pluyckx/SensorPcb/data/schema/Sensor.pdf

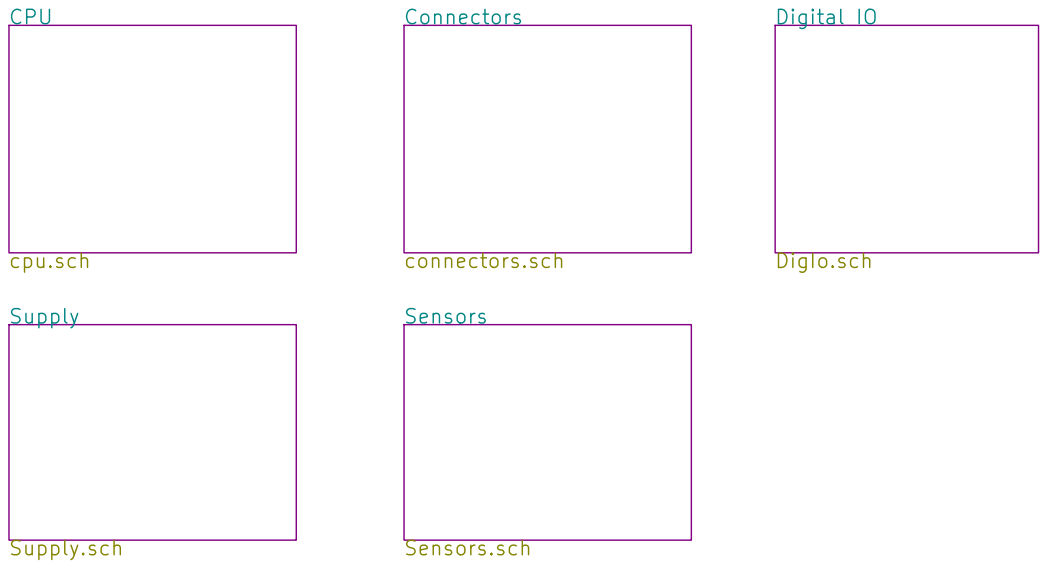
[picture p1: page 1]

Id: 1/6 Title: Sensor File: Sensor.sch Sheet: / Philip Luyckx

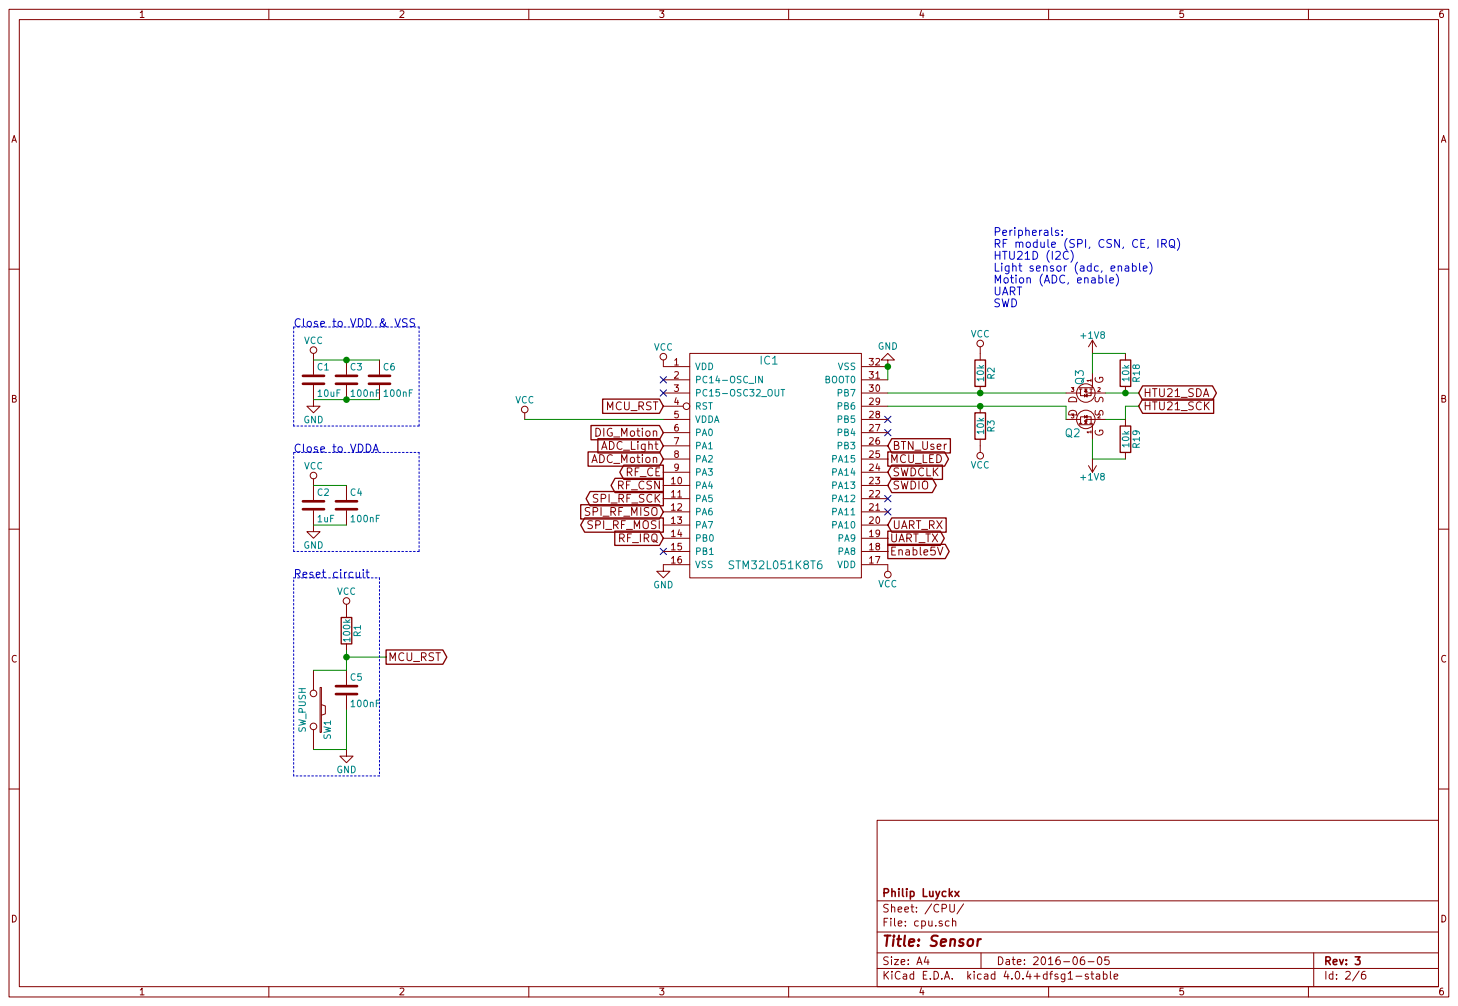
[picture p2: page 2]

Peripherals:
RF module (SPI, CSN, CE, IRQ)
HTU21D (I2C)
Light sensor (adc, enable)
Motion (ADC, enable) UART SWD

100nF VCC GND Close to VDDA

File: cpu.sch Sheet: /CPU/ Philip Luyckx

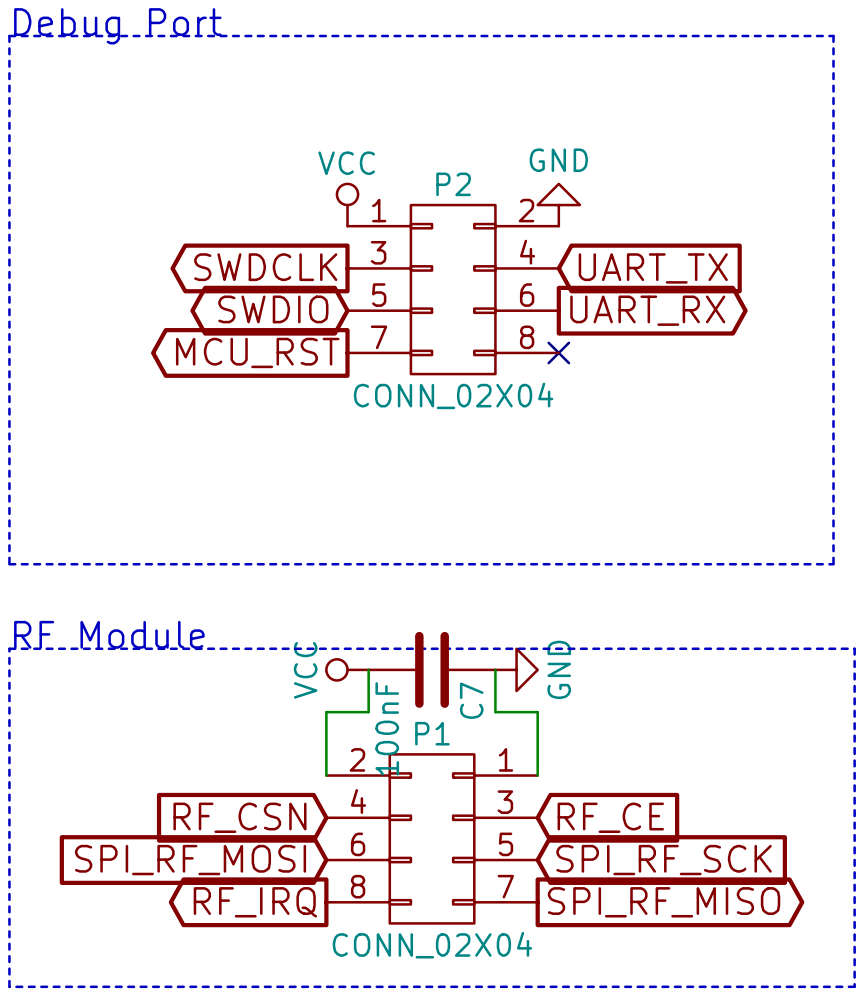
[picture p3: page 3]

Id: 3/6 Title: Sensor File: connectors.sch Sheet: /Connectors/ Philip Luyckx

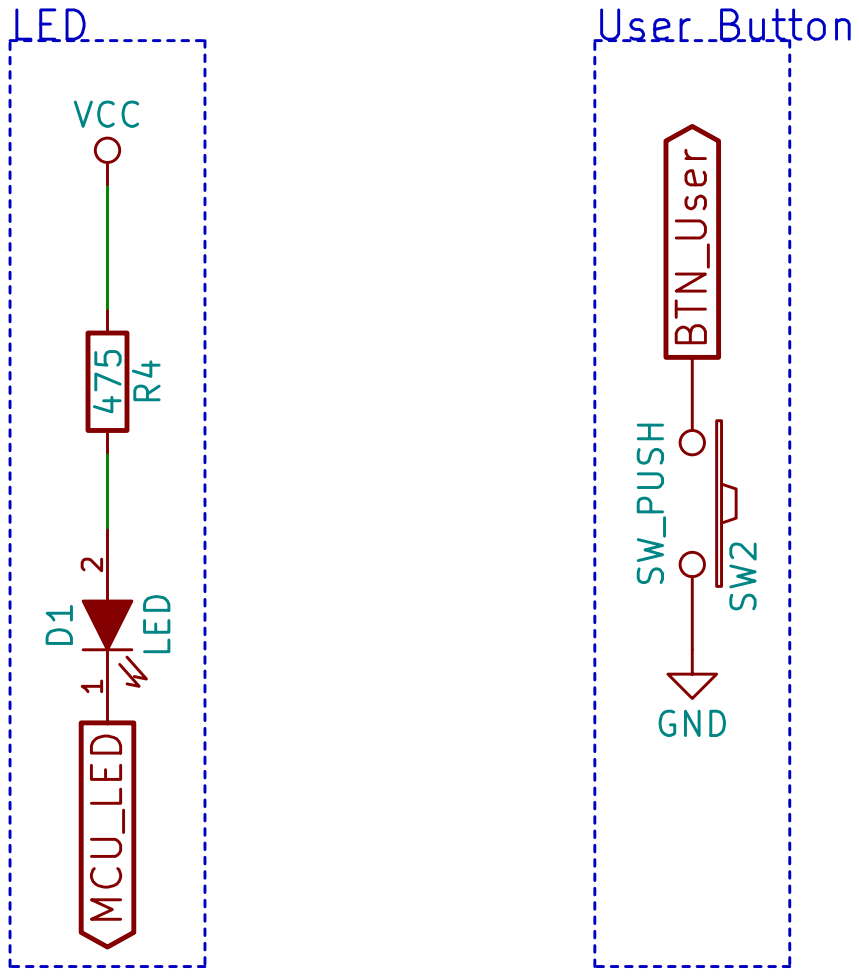
[picture p4: page 4]

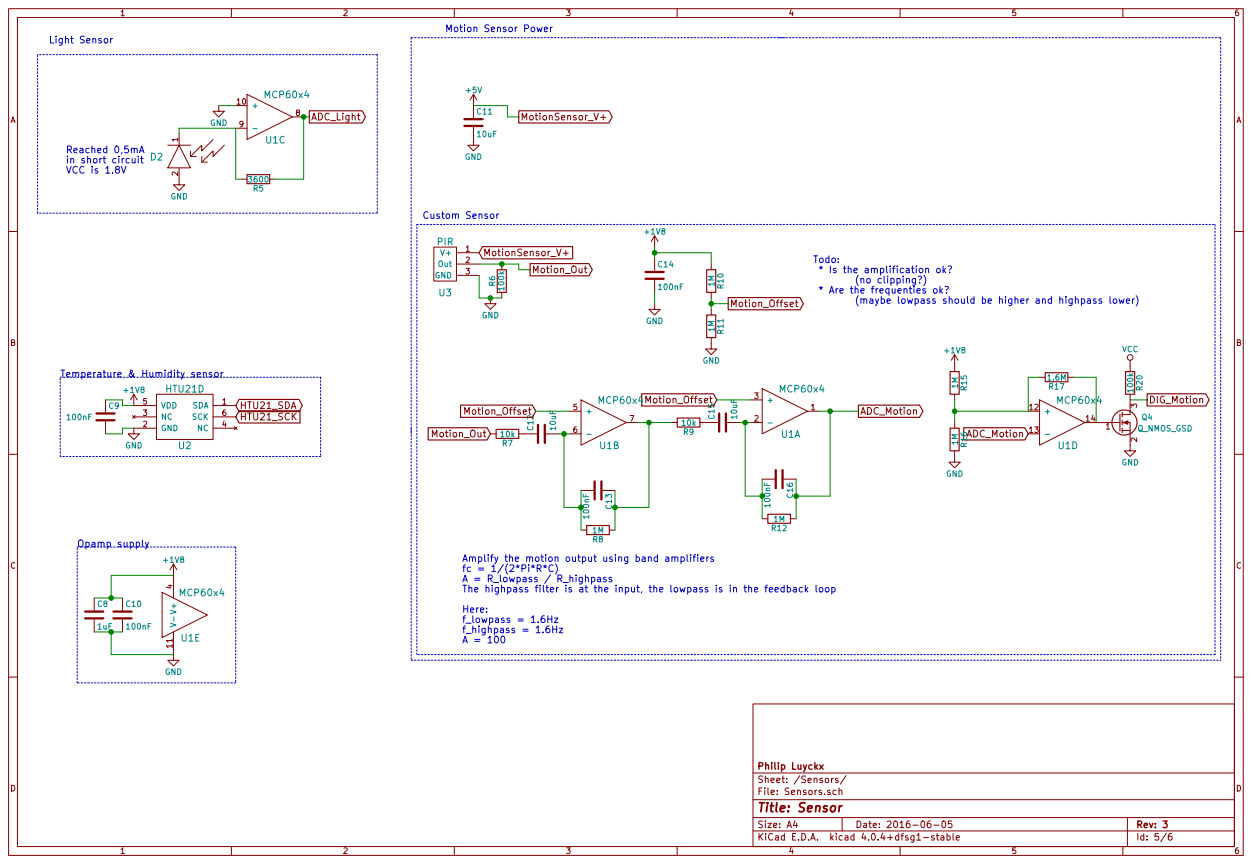
[picture p5: page 5]

(maybe lowpass should be higher and highpass lower) 1 2 D2 Reached 0,5mA
in short circuit VCC is 1.8V

* Is the amplification ok?
(no clipping?)
* Are the frequenties ok?

Amplify the motion output using band amplifiers
A = R_lowpass / R_highpass
The highpass filter is at the input, the lowpass is in the feedback loop Here:

Id: 5/6 Title: Sensor File: Sensors.sch Sheet: /Sensors/ Philip Luyckx

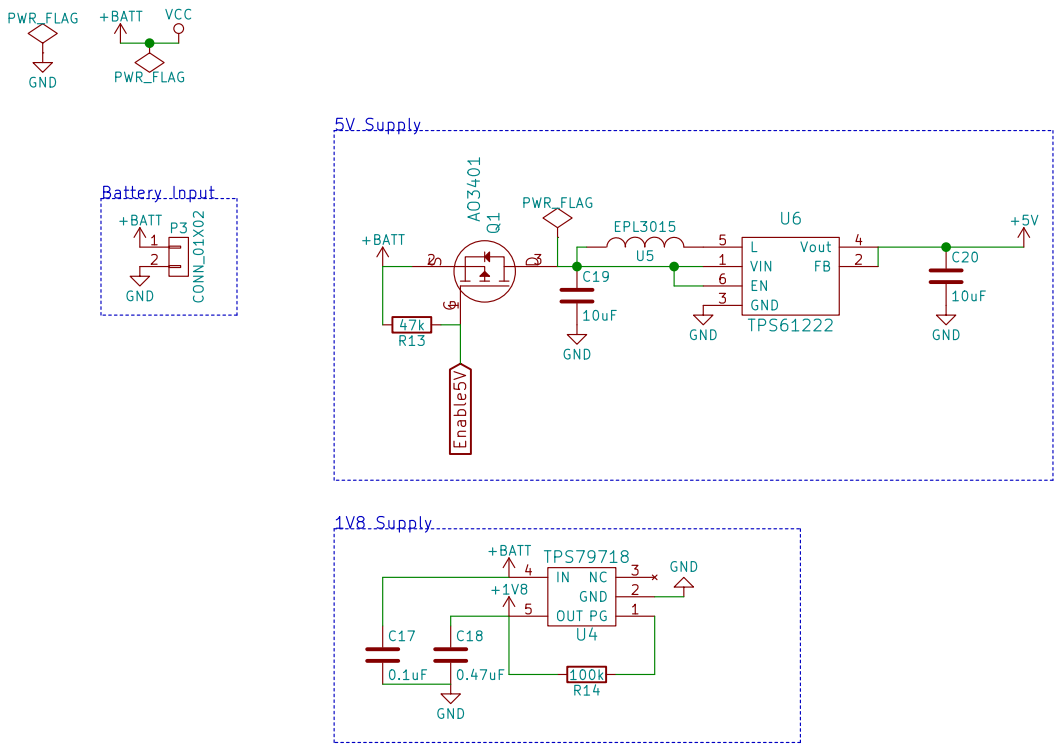
[picture p6: page 6]

2 P3 CONN_01X02+BATT GND Battery Input +BATT GND
PWR_FLAG
