pluyckx/SensorPcb/data/pcb/pdf/pcb-size.pdf

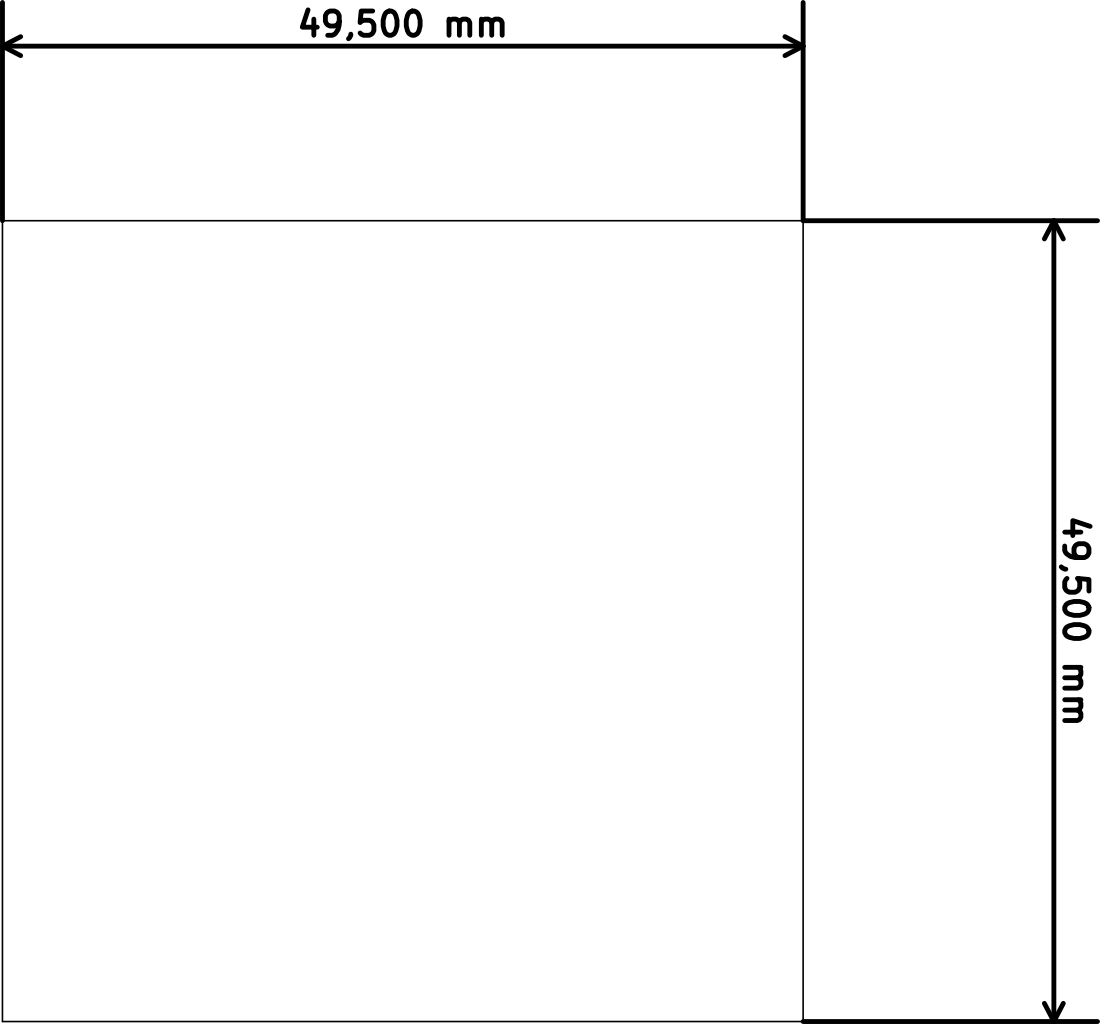
[picture p7: page 1]
