pluyckx/SensorPcb/data/pcb/pdf/Sensor-both-layers.pdf

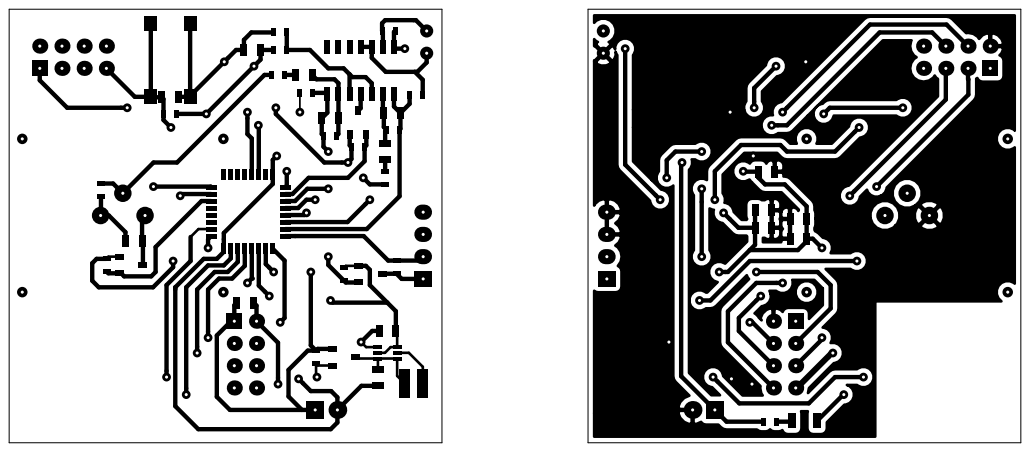
[picture p8: page 1]
