pluyckx/SensorPcb/Sensor.kicad_pcb

## KiCad design Sensor.kicad_pcb (2017-04-18)

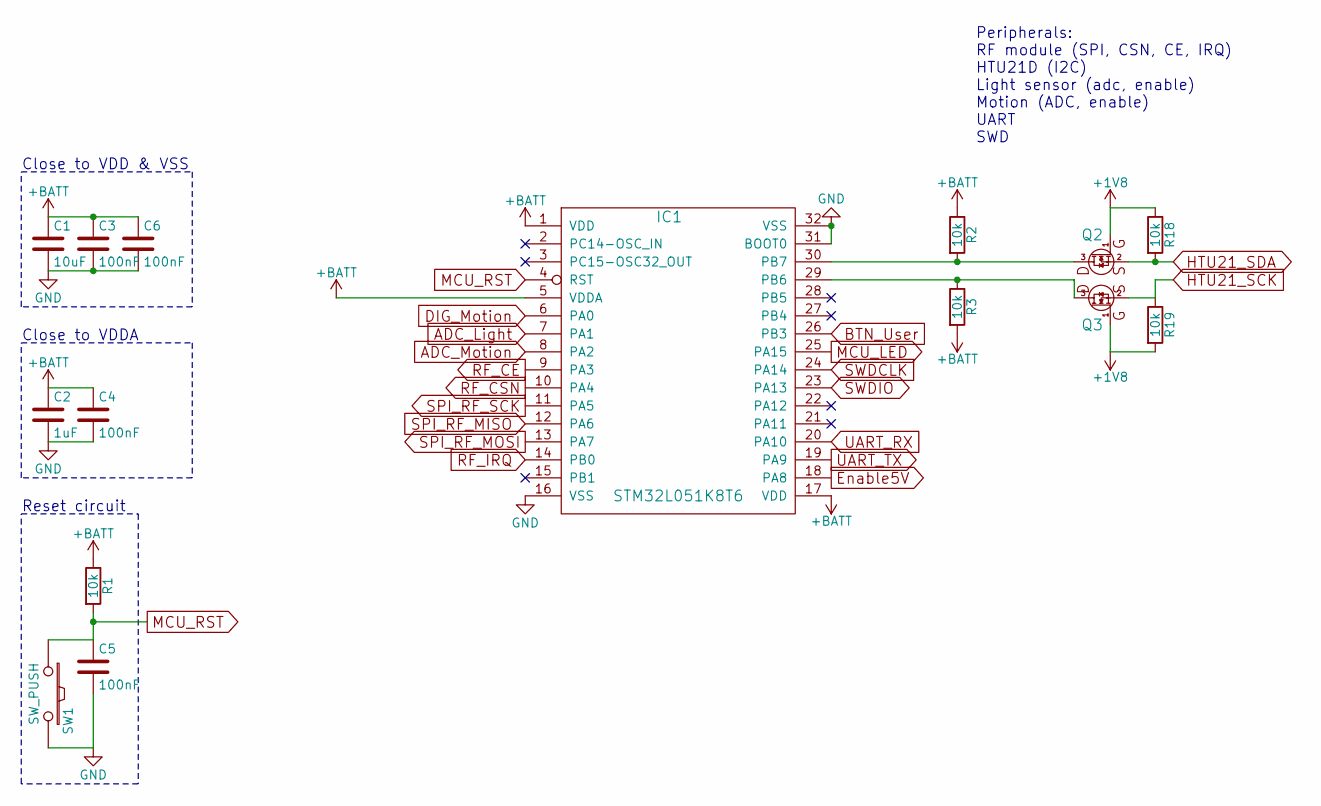
[picture p9: schematic cpu.sch, Sensor]

Parts:
C1: 10uF; R_0805
C2: 1uF; R_0805
C3, C4, C5, C6: 100nF; R_0805
IC1: STM32L051K8T6; STM32L051-LQFP32
Q2, Q3: NMosfetGen; SOT23
R1, R2, R3, R18, R19: 10k; R_0603
SW1: SW_PUSH; MicroSwitch_6x6mm

Connections:
+1V8: Q2.1, Q3.1, R18.1, R19.2; also elsewhere on the board
+BATT: C1.1, C2.1, C3.1, C4.1, C6.1, IC1.1 (VDD), IC1.5 (VDDA), IC1.17 (VDD), R1.1, R2.1, R3.2; also elsewhere on the board
ADC_Light: IC1.7 (PA1); also elsewhere on the board
ADC_Motion: IC1.8 (PA2); also elsewhere on the board
BTN_User: IC1.26 (PB3); also elsewhere on the board
DIG_Motion: IC1.6 (PA0); also elsewhere on the board
Enable5V: IC1.18 (PA8); also elsewhere on the board
GND: C1.2, C2.2, C3.2, C4.2, C5.2, C6.2, IC1.16 (VSS), IC1.31 (BOOT0), IC1.32 (VSS), SW1.2; also elsewhere on the board
HTU21_SCK: Q3.2, R19.1; also elsewhere on the board
HTU21_SDA: Q2.2, R18.2; also elsewhere on the board
MCU_LED: IC1.25 (PA15); also elsewhere on the board
MCU_RST: C5.1, IC1.4 (RST), R1.2, SW1.1; also elsewhere on the board
unnamed: IC1.29 (PB6), Q3.3, R3.1
unnamed: IC1.30 (PB7), Q2.3, R2.2
RF_CE: IC1.9 (PA3); also elsewhere on the board
RF_CSN: IC1.10 (PA4); also elsewhere on the board
RF_IRQ: IC1.14 (PB0); also elsewhere on the board
SPI_RF_MISO: IC1.12 (PA6); also elsewhere on the board
SPI_RF_MOSI: IC1.13 (PA7); also elsewhere on the board
SPI_RF_SCK: IC1.11 (PA5); also elsewhere on the board
SWDCLK: IC1.24 (PA14); also elsewhere on the board
SWDIO: IC1.23 (PA13); also elsewhere on the board
UART_RX: IC1.20 (PA10); also elsewhere on the board
UART_TX: IC1.19 (PA9); also elsewhere on the board

Notes on the sheet:
Close to VDD & VSS
Close to VDDA
Reset circuit
Peripherals: RF module (SPI, CSN, CE, IRQ) HTU21D (I2C) Light sensor (adc, enable) Motion (ADC, enable) UART SWD

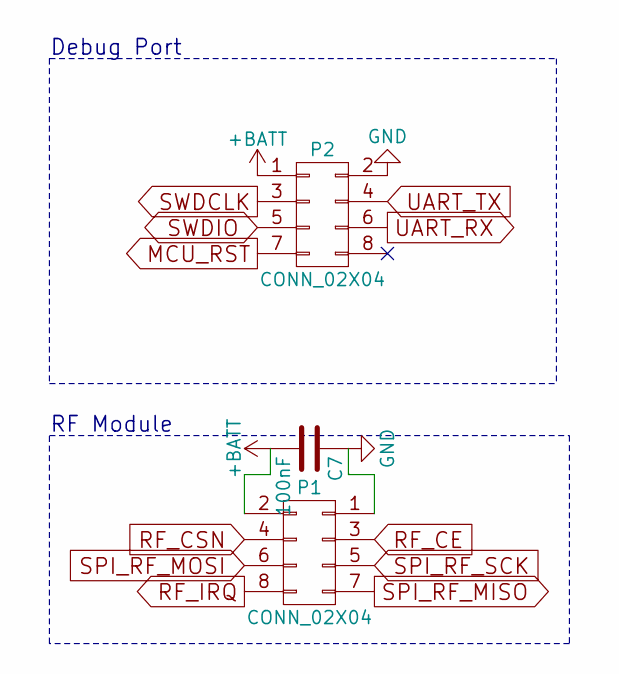
[picture p10: schematic connectors.sch, Sensor]

Parts:
C7: 100nF; R_0805
P1: CONN_02X04; Pin_Header_Straight_2x04_SMD
P2: CONN_02X04; Pin_Header_Straight_2x04_TH

Connections:
+BATT: C7.2, P1.2, P2.1; also elsewhere on the board
GND: C7.1, P1.1, P2.2; also elsewhere on the board
MCU_RST: P2.7; also elsewhere on the board
RF_CE: P1.3; also elsewhere on the board
RF_CSN: P1.4; also elsewhere on the board
RF_IRQ: P1.8; also elsewhere on the board
SPI_RF_MISO: P1.7; also elsewhere on the board
SPI_RF_MOSI: P1.6; also elsewhere on the board
SPI_RF_SCK: P1.5; also elsewhere on the board
SWDCLK: P2.3; also elsewhere on the board
SWDIO: P2.5; also elsewhere on the board
UART_RX: P2.6; also elsewhere on the board
UART_TX: P2.4; also elsewhere on the board

Notes on the sheet:
RF Module
Debug Port

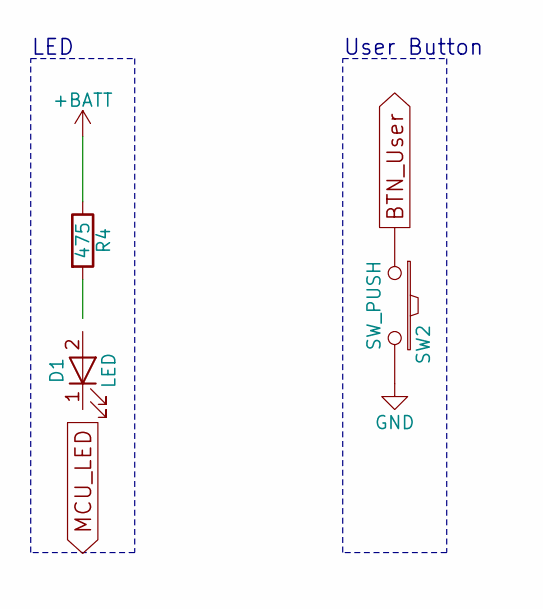
[picture p11: schematic DigIo.sch, Sensor]

Parts:
D1: LED; R_1206
R4: 475; R_0603
SW2: SW_PUSH; MicroSwitch_6x6mm

Connections:
+BATT: R4.1; also elsewhere on the board
BTN_User: SW2.1; also elsewhere on the board
GND: SW2.2; also elsewhere on the board
MCU_LED: D1.1 (K); also elsewhere on the board
unnamed: D1.2 (A), R4.2

Notes on the sheet:
LED
User Button

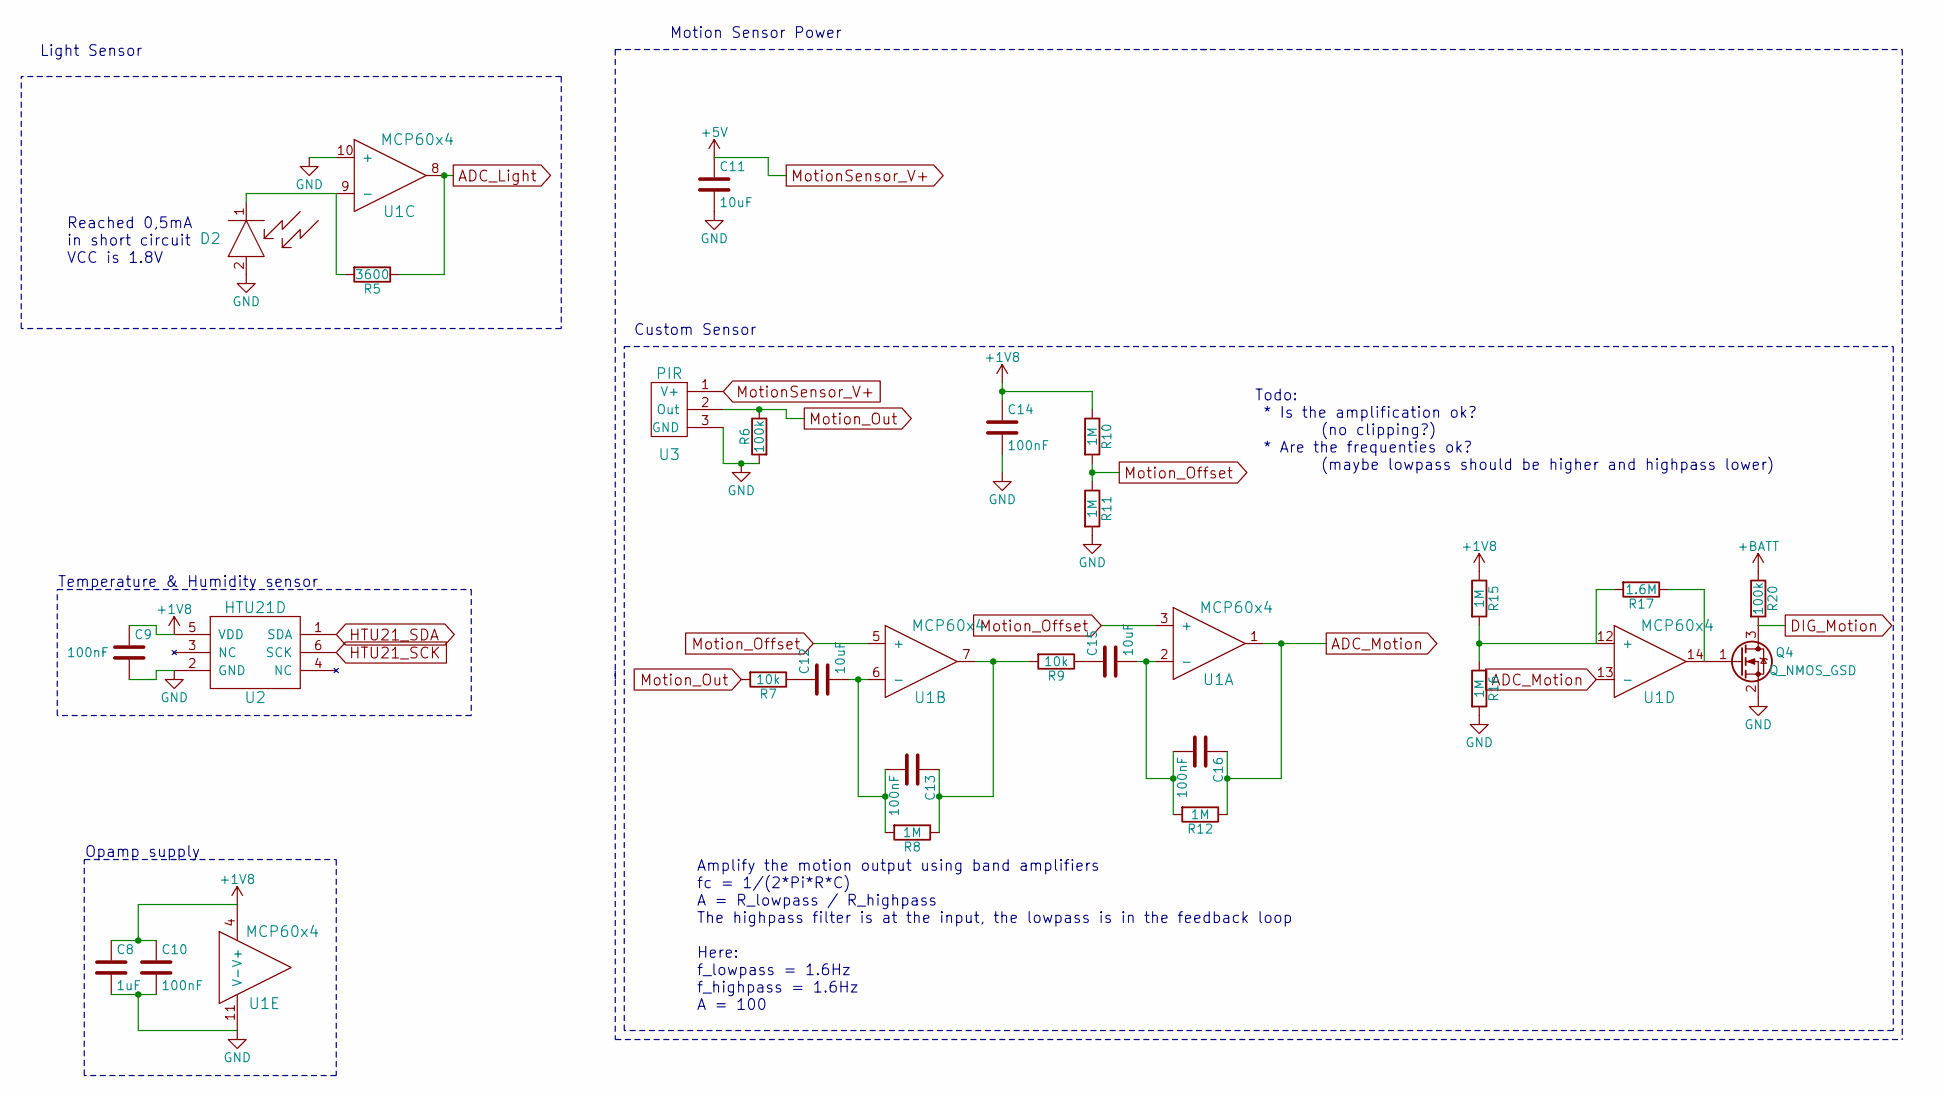
[picture p12: schematic Sensors.sch, Sensor]

Parts:
C8: 1uF; R_0805
C9, C10, C13, C14, C16: 100nF; R_0805
C11, C12, C15: 10uF; R_0805
D2: PhotoDiode; PD638C
Q4: Q_NMOS_GSD; SOT23
R5: 3600; R_0603
R6, R20: 100k; R_0603
R7, R9: 10k; R_0603
R8, R10, R11, R12, R15, R16: 1M; R_0603
R17: 1.6M; R_0603
U1: MCP60x4; SOIC-14
U2: HTU21D; HTU21D_QFN
U3: PIR

Connections:
+1V8: C8.1, C9.1, C10.1, C14.1, R10.1, R15.1, U1.4 (V+), U2.5 (VDD); also elsewhere on the board
+BATT: R20.1; also elsewhere on the board
ADC_Light: R5.1, U1.8; also elsewhere on the board
ADC_Motion: C16.1, R12.1, U1.1, U1.13 (-); also elsewhere on the board
DIG_Motion: Q4.3 (D), R20.2; also elsewhere on the board
GND: C8.2, C9.2, C10.2, C11.2, C14.2, D2.2, Q4.2 (S), R6.2, R11.2, R16.2, U1.10 (+), U1.11 (V-), U2.2 (GND), U3.3 (GND); also elsewhere on the board
HTU21_SCK: U2.6 (SCK); also elsewhere on the board
HTU21_SDA: U2.1 (SDA); also elsewhere on the board
MotionSensor_V+: C11.1, U3.1 (V+); also elsewhere on the board
Motion_Offset: R10.2, R11.1, U1.3 (+), U1.5 (+)
Motion_Out: R6.1, R7.2, U3.2 (Out)
unnamed: C12.1, R7.1
unnamed: C12.2, C13.2, R8.2, U1.6 (-)
unnamed: C13.1, R8.1, R9.2, U1.7
unnamed: C15.1, R9.1
unnamed: C15.2, C16.2, R12.2, U1.2 (-)
unnamed: D2.1, R5.2, U1.9 (-)
unnamed: Q4.1 (G), R17.1, U1.14
unnamed: R15.2, R16.1, R17.2, U1.12 (+)

Notes on the sheet:
Motion Sensor Power
Custom Sensor
Light Sensor
Amplify the motion output using band amplifiers fc = 1/(2*Pi*R*C) A = R_lowpass / R_highpass The highpass filter is at the input, the lowpass is in the feedback loop Here: f_lowpass = 1.6Hz f_highpass = 1.6Hz A = 100
Todo: * Is the amplification ok? (no clipping?) * Are the frequenties ok? (maybe lowpass should be higher and highpass lower)
Reached 0,5mA in short circuit VCC is 1.8V
Temperature & Humidity sensor
Opamp supply

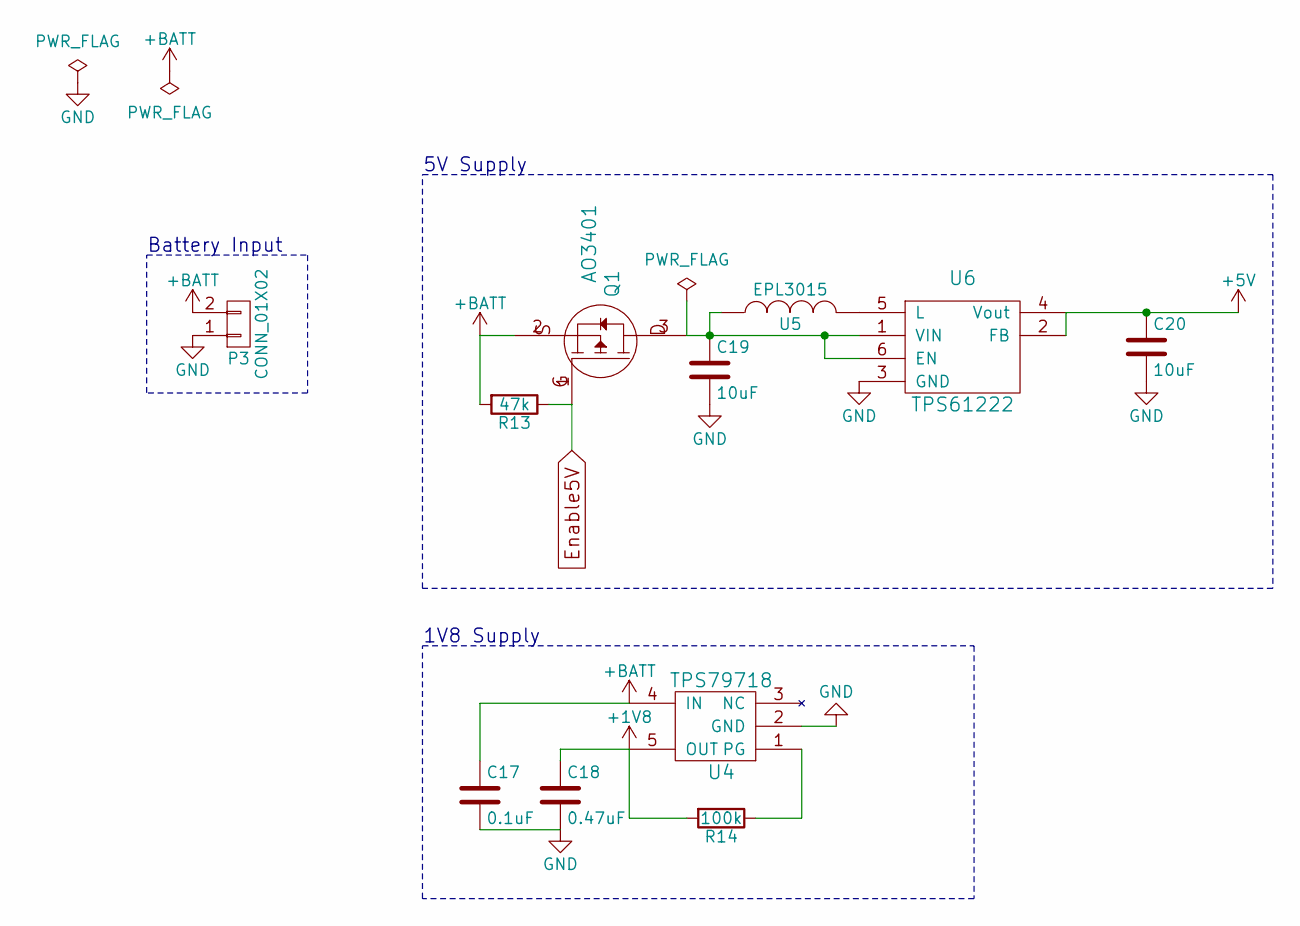
[picture p13: schematic Supply.sch, Sensor]

Parts:
C17: 0.1uF; R_0805
C18: 0.47uF; R_0805
C19, C20: 10uF; R_0805
P3: CONN_01X02; ConnWago_2059_2P_SMD
Q1: AO3401; SOT23
R13: 47k; R_0603
R14: 100k; R_0603
U4: TPS79718; SC70
U5: EPL3015
U6: TPS61222; TPS6122x

Connections:
+1V8: C18.1, R14.2, U4.5 (OUT); also elsewhere on the board
+BATT: C17.1, P3.2, Q1.2, R13.2, U4.4 (IN); also elsewhere on the board
Enable5V: Q1.1, R13.1; also elsewhere on the board
GND: C17.2, C18.2, C19.2, C20.2, P3.1, U4.2 (GND), U6.3 (GND); also elsewhere on the board
MotionSensor_V+: C20.1, U6.2 (FB), U6.4 (Vout); also elsewhere on the board
unnamed: C19.1, Q1.3, U5.1, U6.1 (VIN), U6.6 (EN)
unnamed: R14.1, U4.1 (PG)
unnamed: U5.2, U6.5 (L)

Notes on the sheet:
Battery Input
5V Supply
1V8 Supply

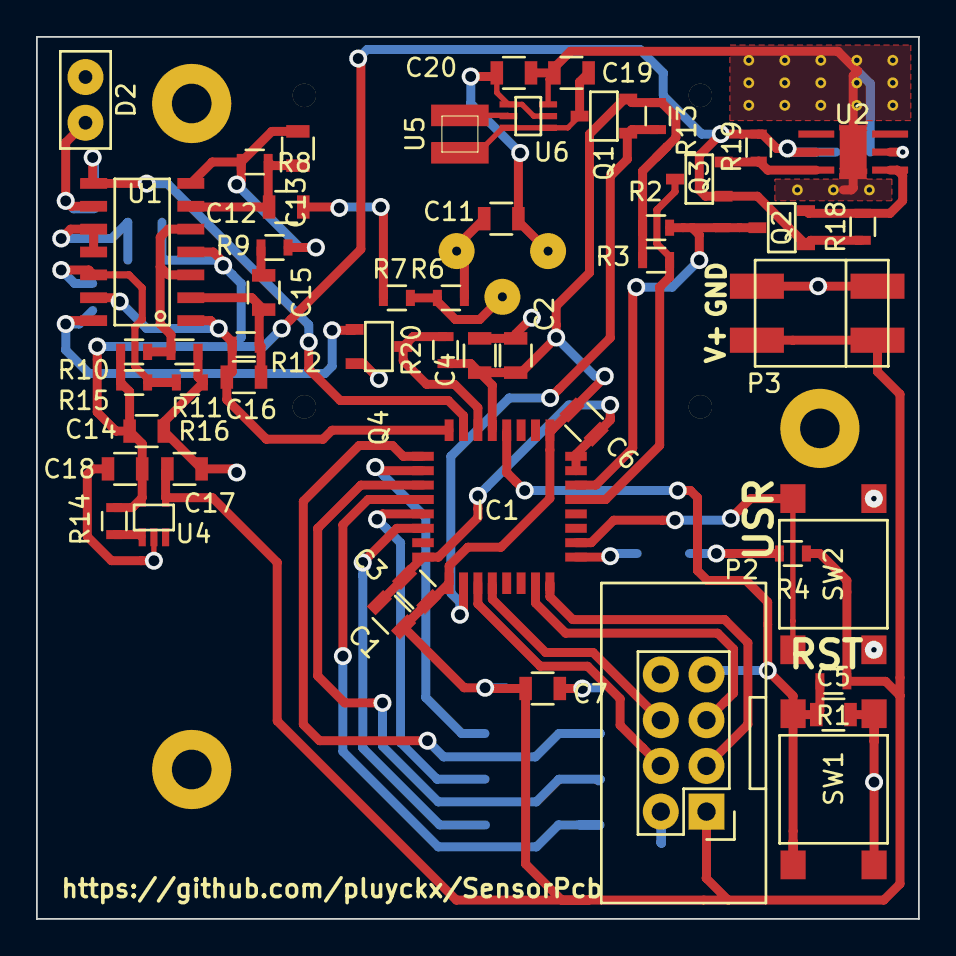
[picture p14: board Sensor.kicad_pcb from above]

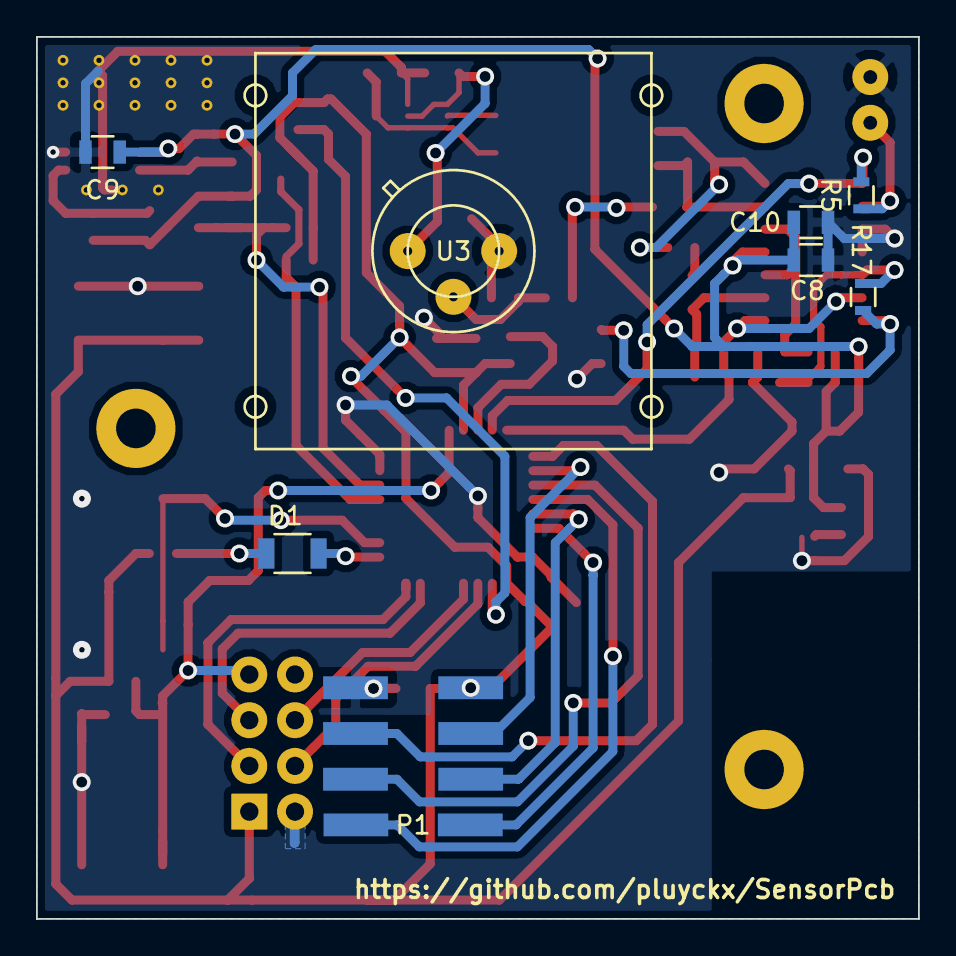
[picture p15: board Sensor.kicad_pcb from below]

Board: 2 copper layers, 49.0 x 49.0 mm, 58 parts (8 on the bottom side), 39 nets.
