pluyckx/SensorPcb/SensorActuator.kicad_pcb

## KiCad design SensorActuator.kicad_pcb (2016-03-06)

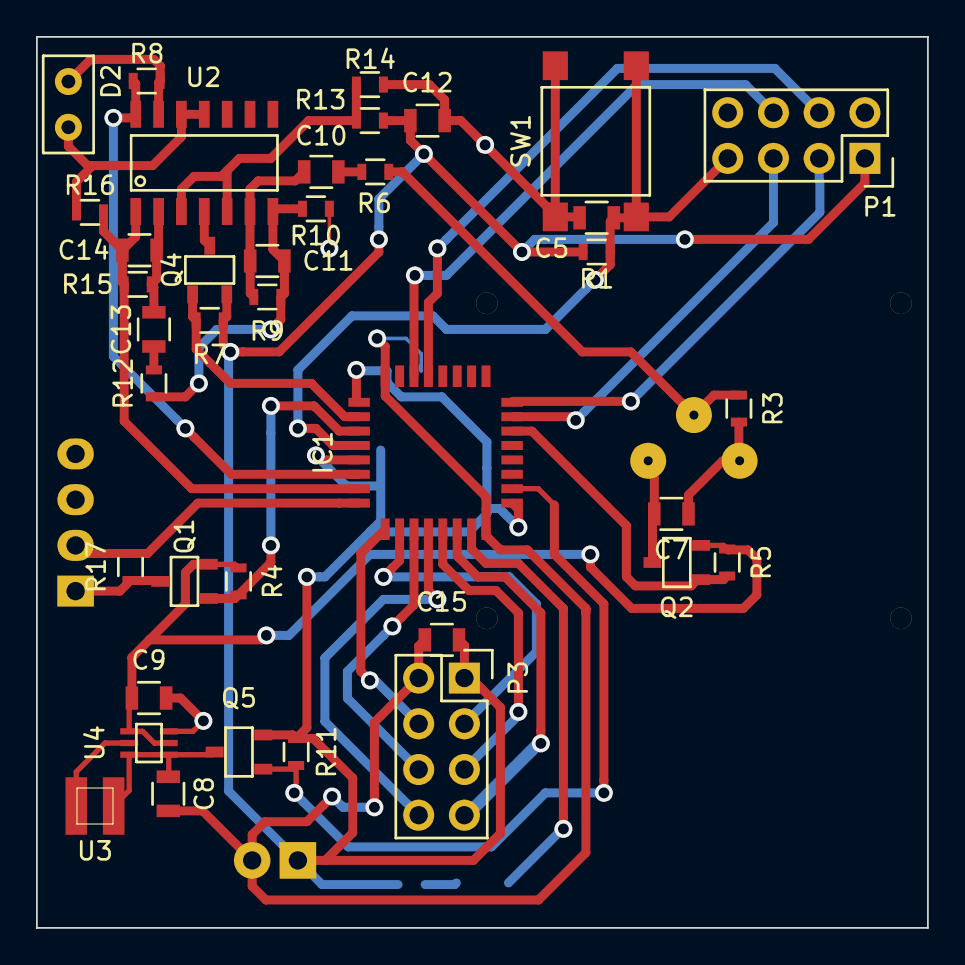
[picture p16: board SensorActuator.kicad_pcb from above]

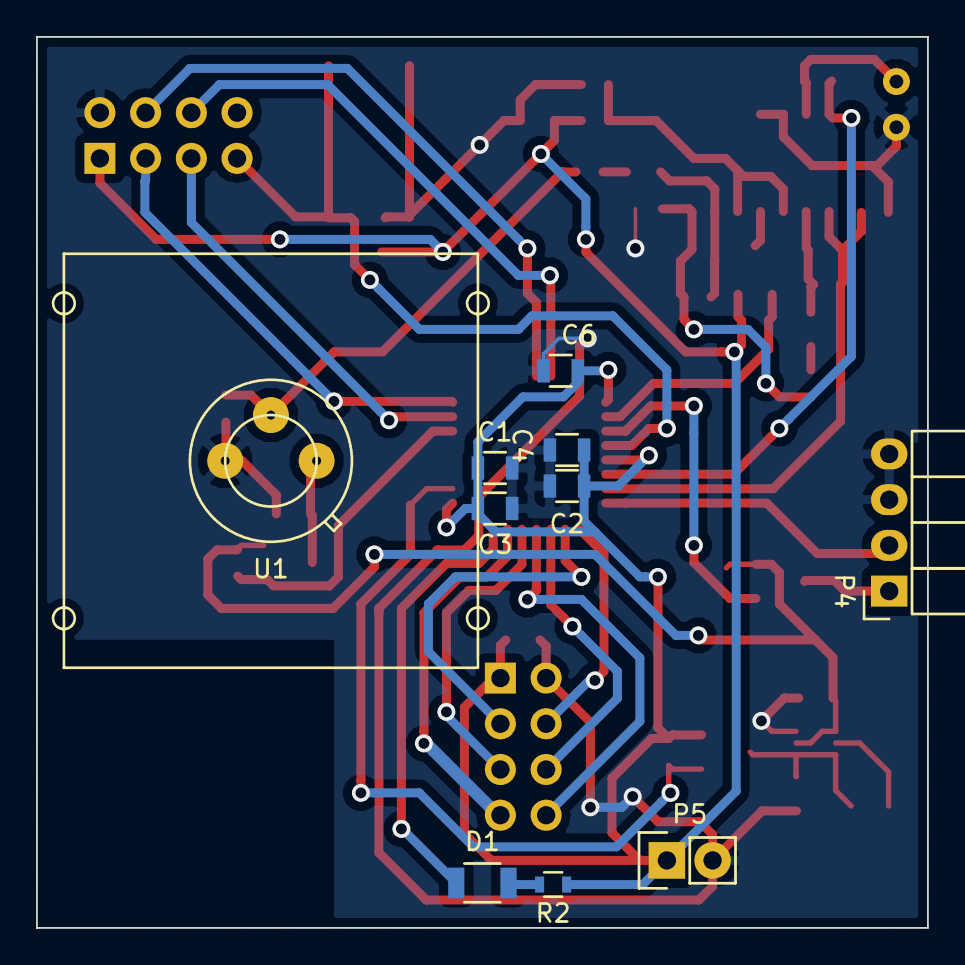
[picture p17: board SensorActuator.kicad_pcb from below]

Board: 2 copper layers, 49.5 x 49.5 mm, 48 parts (10 on the bottom side), 36 nets.

Parts:
C1, C7, C8, C9, C10, C13: 10uF; R_0805
C2: 1uF; R_0805
C3, C4, C5, C6, C11, C14: 100nF; R_0805
C12, C15: C; R_0805
D1: LED; R_1206
D2: PhotoDiode; PD638C
IC1: STM32L051K8T6; STM32L051-LQFP32
P1, P3: CONN_02X04; Socket_Strip_Straight_2x04
P4: CONN_01X04; Socket_Strip_Angled_1x04
P5: CONN_01X02; Socket_Strip_Straight_1x02
Q1, Q2, Q4: PMosfetGen; SOT23
Q5: AO3401; SOT23
R1, R3, R13, R14: 100k; R_0603
R2: 475; R_0603
R4, R5, R7: 47.5k; R_0603
R6, R10, R12, R16: 10k; R_0603
R8: 3600; R_0603
R9, R15: 1M; R_0603
R11: 47k; R_0603
R17: 1k; R_0603
SW1: SW_PUSH; MicroSwitch_6x6mm
U1: PIR
U2: MCP6004; SOIC-14
U3: EPL3015
U4: TPS61222; TPS6122x

Connections:
+5V: C9.1, Q1.2, Q2.2, R4.1, R5.1, U4.2, U4.4
+BATT: C1.1, C2.1, C3.1, C4.1, C6.1, C12.1, C15.2, IC1.1, IC1.5, IC1.17, P1.1, P3.1, P5.1, Q4.2, Q5.2, R1.1, R2.1, R7.1, R11.2, R13.1
ADC_Light: IC1.6, R8.1, U2.14
ADC_Motion: C14.1, IC1.7, R15.1, R16.1, U2.1
DHT22_Enable: IC1.3, Q1.1, R4.2
Enable5V: IC1.18, Q5.1, R11.1
GND: C1.2, C2.2, C3.2, C4.2, C5.2, C6.2, C7.2, C8.2, C9.2, C12.2, C15.1, D2.2, IC1.16, IC1.32, P1.2, P3.2, P4.3, P4.4, P5.2, R3.2, R10.2, R14.2, R16.2, SW1.2, U1.3, U2.11, U2.12, U4.3
MCU_LED: D1.1, IC1.15
MCU_RST: C5.1, IC1.4, P1.7, R1.2, SW1.1
MotionSens_Enable: IC1.22, Q2.1, R5.2
MotionSensor_V+: C7.1, Q2.3, U1.1
Motion_Offset: R13.2, R14.1, U2.3, U2.5
Motion_Out: R3.1, R6.2, U1.2
unnamed: C8.1, Q5.3, U3.1, U4.1, U4.6
unnamed: C10.1, R6.1
unnamed: C10.2, C11.2, R9.2, U2.6
unnamed: C11.1, R9.1, R10.1, R12.2, U2.7
unnamed: C13.1, R12.1
unnamed: C13.2, C14.2, R15.2, U2.2
unnamed: D1.2, R2.2
unnamed: D2.1, R8.2, U2.13
unnamed: P4.1, Q1.3, R17.1
unnamed: U3.2, U4.5
OpampEnable: IC1.2, Q4.1, R7.2
Opamp_V+: Q4.3, U2.4
RF_CE: IC1.9, P3.4
RF_CSN: IC1.10, P3.3
RF_IRQ: IC1.14, P3.7
SPI_RF_MISO: IC1.12, P3.8
SPI_RF_MOSI: IC1.13, P3.5
SPI_RF_SCK: IC1.11, P3.6
SWDCLK: IC1.24, P1.3
SWDIO: IC1.23, P1.5
Temp_1Wire: IC1.8, P4.2, R17.2
UART_RX: IC1.30, P1.6
UART_TX: IC1.29, P1.4
