pluyckx/SensorPcb/stm32l051.ioc

Mcu.UserName=STM32L051K8Tx
PA0.GPIO_Label=LightAdc
PA0.Signal=ADC_IN0
PA1.GPIO_Label=MotionAdc
PA1.Signal=ADC_IN1
PA10.Signal=USART1_RX
PA13.Signal=SYS_SWDIO
PA14.Signal=SYS_SWCLK
PA15.GPIO_Label=Led
PA15.Signal=GPIO_Output
PA3.GPIO_Label=RfCe
PA3.Signal=GPIO_Output
PA4.Signal=SPI1_NSS
PA5.GPIO_Label=RfSck
PA5.Signal=SPI1_SCK
PA6.GPIO_Label=RfMiso
PA6.Signal=SPI1_MISO
PA7.GPIO_Label=RfMosi
PA7.Signal=SPI1_MOSI
PA8.GPIO_Label=5VEnable
PA8.Signal=GPIO_Output
PA9.Signal=USART1_TX
PB0.GPIO_Label=RfIrq
PB0.Signal=GPIO_Input
PB6.GPIO_Label=HTU21_SCK
PB6.Signal=I2C1_SCL
PB7.GPIO_Label=HTU21_SDA
PB7.Signal=I2C1_SDA
