pluyckx/SensorPcb/(commit log)

2015-12-11 Initial version of sensor pcb
    [Boost.sch, DigIo.sch, PIRSensor.sch, SensorActuator.kicad_pcb, SensorActuator.sch, Sensors.sch, Supply.sch, connectors.sch]
2015-12-11 Version 2 of the pcb
    * PCB is now exact 50x38 mm, so we can print it on a small board
    * Through hole components have only a pad on one side,
    this way we are sure we connect the correct pad
    [SensorActuator.kicad_pcb]
2015-12-11 Add drill holes
    [SensorActuator.kicad_pcb]
2015-12-11 Remove VCC from UART-DBG connector
    * VCC of a USB-TTL connector may not be connected to VCC of the board.
    The usb will put 3.3V (or 5V) on this pin, so we will create a short
    circuit if we connect the TLL and use a battery as supply.
    [SensorActuator.kicad_pcb, connectors.sch]
2015-12-13 Increase clearance for fill zones to 0.4mm
    [SensorActuator.kicad_pcb, cpu.sch]
2015-12-13 Fix a 5V trace
    [SensorActuator.kicad_pcb]
2015-12-13 Prepare for release V1
    [Sensor.drl]
2015-12-31 Created some more outputs of V1
    [SensorActuator.csv, SensorActuator.kicad_pcb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]
2015-12-31 Correct some schematics and add todos on pcb
    [SensorActuator.kicad_pcb, Sensors.sch]
2016-01-24 Add Opamp circuit
    * Amplify the output of the motion sensor using a AC coupled band
    amplifier.
    * Use one of the opamp circuits as a voltage follower for the light
    sensor to limit the output to 0V and VCC.
    [DigIo.sch, Sensors.sch, Supply.sch, connectors.sch, cpu.sch]
2016-02-12 Update schematic and reroute print
    * Update opamp circuit for light sensor
    * Change opamp
    * Reroute everything
    [DigIo.sch, SensorActuator.csv, SensorActuator.kicad_pcb, Sensors.sch, Supply.sch, connectors.sch, cpu.sch]
2016-02-12 Use 0603 resistors
    [DigIo.sch, SensorActuator.csv, SensorActuator.kicad_pcb, Sensors.sch, Supply.sch, cpu.sch]
2016-02-14 Finalize pcb
    * Make pcb 50x50mm
    * Increase clearance for filled zones
    [SensorActuator.kicad_pcb]
2016-02-14 Add release files
    [SensorActuator.kicad_pcb]
2016-03-03 Update pull-up resistor for a sensor
    [SensorActuator.kicad_pcb, Sensors.sch, cpu.sch]
2016-03-06 Finish work on V2
    * Rework layout
    * Reassign mcu pins
    * Add a capacitor for the RF module
    [DigIo.sch, SensorActuator.kicad_pcb, Sensors.sch, Supply.sch, connectors.sch, cpu.sch]
2016-03-06 Only use one ground plane and reduce pcb size
    [SensorActuator.kicad_pcb]
2016-03-06 Remove previous output files
    [Sensor.drl, SensorActuator-B.Cu.gbr, SensorActuator-Cmts.User.gbr, SensorActuator-F.Cu.gbr]
2016-03-06 Correct some silks
    [SensorActuator.kicad_pcb]
2016-03-06 Rename project and generate output files
    [Sensor.kicad_pcb, Sensor.sch, SensorActuator.csv]
2016-03-12 Add M3 mounting holes
    [Sensor.kicad_pcb]
2016-03-16 Change texts for connectors and fix track width
    [DigIo.sch, Sensor.kicad_pcb, Sensors.sch, Supply.sch, connectors.sch, cpu.sch]
2016-03-20 Fix Boot0 pin and add prices per component
    [DigIo.sch, Sensor.kicad_pcb, Sensors.sch, Supply.sch, connectors.sch, cpu.sch]
2016-03-27 Fix Boot0 pin and mechanical problem with the Fresnel lens
    * Resistor at Boot0 pin not necessary:
    it is only input and can directly connected to ground
    * The capacitors above the cpu on the bottom layer are not
    correctly placed: there is a problem when placing the
    Fresnel lens.
    [Sensor.kicad_pcb, cpu.sch]
2016-06-04 Update schematics for V3:
    * Change DHT22 to HTU21D
    * Change schematic for MCP6044
    * Correct unused opamp + power supply
    * Reassign some cpu pins (for HTU21D)
    * Add LDO power supply for 1.8V
    * Update STM32CubeMx project
    [DigIo.sch, Sensor.sch, Sensors.sch, Supply.sch, connectors.sch, cpu.sch]
2016-06-05 Updates for V3:
    * Remove unnecessary power supply enable MOSFETs
    * Optimize pin configuration
    [DigIo.sch, Sensors.sch, Supply.sch, connectors.sch, cpu.sch]
2016-06-10 Finish schematic, assign all footprints for V3
    [DigIo.sch, Sensor.kicad_pcb, Sensor.sch, Sensors.sch, Supply.sch, connectors.sch, cpu.sch]
2016-06-26 Finish routing v4
    [Sensor.kicad_pcb, Sensors.sch]
2016-07-22 Update some routing
    [Sensor.kicad_pcb, Sensors.sch, Supply.sch, cpu.sch]
2016-07-22 Add extra switch for user defined functionality
    * reroute pcb
    [DigIo.sch, Sensor.kicad_pcb, Sensors.sch, Supply.sch, cpu.sch]
2016-07-22 Update schematic pdf
2016-09-12 Add data files for pcb
2016-09-12 Remove unnecessary via
    [Sensor.kicad_pcb]
2016-09-15 Update QFN package for easier soldering
    [Sensor.kicad_pcb]
2017-02-05 Corrections I2C and Dig Opamp out
    * Fix level shift for I2C
    * Fix level shift opamp digital out (PIR)
    [DigIo.sch, Sensor.kicad_pcb, Sensors.sch, Supply.sch, connectors.sch, cpu.sch]
2017-02-12 Update connectors to custom ones
    [DigIo.sch, Sensor.kicad_pcb, Sensors.sch, Supply.sch, connectors.sch, cpu.sch]
2017-02-17 Add prices
    [DigIo.sch, Sensor.kicad_pcb, Sensors.sch, Supply.sch, connectors.sch, cpu.sch]
2017-03-05 Update connector for Vin
    [Sensor.kicad_pcb, Supply.sch]
2017-03-05 Make panelized pcb & generate gerbers
    [Sensor-B.Cu.gbr, Sensor-B.Mask.gbr, Sensor-B.Paste.gbr, Sensor-B.SilkS.gbr, Sensor-Edge.Cuts.gbr, Sensor-F.Cu.gbr, Sensor-F.Mask.gbr, Sensor-F.Paste.gbr]
2017-03-08 Finish layout
    [Sensor.kicad_pcb, Sensor_panels.kicad_pcb, connectors.sch]
2017-03-08 Add url to open source project on silkscreens
    [Sensor.kicad_pcb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]
2017-03-08 Use correct generated files for seeedstudio
    [Sensor_panels-B.Cu.gbl, Sensor_panels-B.Mask.gbs, Sensor_panels-B.SilkS.gbo, Sensor_panels-Cmts.User.gbr, Sensor_panels-Edge.Cuts.gm1, Sensor_panels-F.Cu.gtl, Sensor_panels-F.Mask.gts, Sensor_panels-F.SilkS.gto]
2017-04-18 Add last changes and gerber files
    [Sensor-B.Cu.gbr, Sensor-B.Mask.gbr, Sensor-B.SilkS.gbr, Sensor-Edge.Cuts.gbr, Sensor-F.Cu.gbr, Sensor-F.Mask.gbr, Sensor-F.SilkS.gbr, Sensor.drl]
2017-04-18 Add description of debug connector pinout
